v-prokofev/wtrans/docs/connection_guide.md

# Инструкция по подключению конвертера (для инженеров)

## 1. Что тебе понадобится
1. **Блок питания**: 24В постоянного тока (DC).
2. **Преобразователь USB-RS485**: 2 штуки (один для датчика, если хочешь проверить его отдельно, второй — для отладки нашей платы).
3. **Датчик ДВУ-01**.
4. **Прямые руки и отвертка**.

---

## 2. Шаг 1: Подключение датчика ДВУ-01 к нашей плате
Датчик подключается к разъемам **X2** (данные) и **X7/X12** (питание).

| Контакт датчика | Сигнал | Куда втыкать на нашей плате |
| :--- | :--- | :--- |
| **1** | DATA- (B) | **X2 - контакт 2** (B) |
| **2** | DATA+ (A) | **X2 - контакт 1** (A) |
| **3** | +12...24V | **X7 (или X12) - контакт 1** (+) |
| **4** | GND | **X7 (или X12) - контакт 2** (-) |

> **Важно:** Если перепутаешь A и B, ничего не сгорит, но данные не пойдут. Если перепутаешь + и - на питании — датчику может стать плохо. Будь внимателен!

---

## 3. Шаг 2: Подключение к компьютеру (Отладка)
Чтобы видеть, что происходит внутри платы, подключаем компьютер к разъему **X3**. Тебе понадобится свисток USB-RS485.

1. **Соедини провода**:
    *   Свисток **A** -> **X3 - контакт 1** (A)
    *   Свисток **B** -> **X3 - контакт 2** (B)
2. **Настрой компьютер**:
    *   Открой **PuTTY** или любую терминалку.
    *   Выбери нужный COM-порт.
    *   Скорость: **115200**.
    *   Data bits: **8**, Stop bits: **1**, Parity: **None**.

---

## 4. Шаг 3: Питание системы
Подай 24В на разъем **X6**.

*   **X6 - контакт 1**: +24В
*   **X6 - контакт 2**: Общий (GND)

---

## 5. Как понять, что всё работает (Светодиод PA9)
После подачи питания посмотри на светодиод на плате:

1. **Мигает РЕДКО (раз в 2 секунды)**:
    *   Плата работает, но **НЕ ВИДИТ** датчик.
    *   Проверь провода на X2.
    *   Проверь, подано ли питание на датчик (X7).
    *   Поменяй местами A и B на разъеме X2.
2. **Мигает ЧАСТО (5 раз в секунду)**:
    *   Всё супер! Плата получает данные от датчика и гонит ток в петлю.
3. **Вообще не горит**:
    *   Либо нет питания на X6, либо ты очень везучий и сжег плату.

---

## 6. Подключение токовой петли и проверка мультиметром (4-20 мА)
Чтобы проверить, что плата реально выдает нужный ток, тебе понадобится мультиметр.

### Как мерить ток (Инструкция для тех, кто забыл):
1. **Переткни щупы**: Красный щуп мультиметра должен стоять в гнезде **"mA"**, а не в "V".
2. **Режим**: Поставь переключатель в положение **mA DC** (постоянный ток).
3. **Подключение**: Мультиметр подключается **В РАЗРЫВ** цепи (последовательно).

### Схема подключения к нашей плате:
*   **Вариант А (простая проверка)**: 
    *   Просто ткни щупами в разъем петли: Красный к **LOOP_P (+)**, Черный к **LOOP_N (-)**. 
    *   Мультиметр сам станет "нагрузкой" и покажет ток.
*   **Вариант Б (в работающей системе)**:
    *   `Плата (LOOP_P)` -> `Прибор (+)`
    *   `Прибор (-)` -> `Щуп мультиметра (+)`
    *   `Щуп мультиметра (-)` -> `Плата (LOOP_N)`

### Что ты должен увидеть:
*   Если датчик не подключен: **3.5 мА** (наш Low Error).
*   Если всё Ок и штиль: **4.0 мА**.
*   Если дует на всю катушку (60 м/с): **20.0 мА**.

> **ОПАСНО:** Самая частая ошибка — оставить щупы в гнезде **mA** (низкое сопротивление) и полезть ими мерить напряжение на входе **X6 (24V)**. 
> В этом случае мультиметр сработает как кусок толстой проволоки и устроит **короткое замыкание**. 
> **Правило:** Сначала меряешь напряжение на питании (режим V), и ТОЛЬКО ПОТОМ перетыкаешь щуп в mA, чтобы лезть в токовую петлю.
