v-prokofev/wtrans/(list of files, drawings)

Other design files:
pcb/An_IF_Converter_V1.0.PrjPcb
pcb/LOOP_DAC.SchDoc
pcb/MCU.SchDoc
pcb/MECHANICAL.SchDoc
pcb/POWER.SchDoc
pcb/SERIAL_IF.SchDoc
pcb/TOP.SchDoc
