v-prokofev/wtrans/fw/Core/Src/dac.c

/**
 * @file    dac.c
 * @brief   DAC161S997 driver — two independent 4-20 mA current loop outputs.
 *
 * Hardware connections (from project_spec.md):
 *   SPI1  : PA5=SCK, PA6=MISO, PA7=MOSI  (Full-Duplex Master, 1.125 MHz)
 *   DAC1  : PA4 = nCS  (Speed channel)
 *   DAC2  : PB0 = nCS  (Direction channel)
 *   nERR1 : PB1 = DAC1 error flag (active LOW)
 *   nERR2 : PB2 = DAC2 error flag (active LOW)
 *
 * DAC161S997 protocol:
 *   - 3-byte SPI frames: [Addr(8)] [Data_MSB(8)] [Data_LSB(8)]
 *   - CPOL=0, CPHA=1 (Mode 1)  — see datasheet p.23
 *   - CS active LOW, toggled around each 3-byte transaction
 *
 * Current formula:
 *   I_out = (CODE / 65536) * 24 mA
 *   CODE  = (I_mA / 24.0) * 65536
 */

#include "dac.h"
#include <stddef.h>

/* -------------------------------------------------------------------------
 * Private variables
 * ------------------------------------------------------------------------- */
static SPI_HandleTypeDef *_hspi = NULL;

/* Last written codes — used for SPI keepalive refresh */
static uint16_t _last_code[3] = {0};  /* index 1=SPEED, 2=DIRECTION */

/* -------------------------------------------------------------------------
 * Private helpers
 * ------------------------------------------------------------------------- */

/** Assert chip-select for the given channel (drive CS LOW). */
static inline void cs_select(uint8_t channel)
{
    if (channel == DAC_CHANNEL_SPEED)
        HAL_GPIO_WritePin(GPIOB, GPIO_PIN_0, GPIO_PIN_RESET); /* PB0 = pin 18 = DAC1_nCS */
    else
        HAL_GPIO_WritePin(GPIOA, GPIO_PIN_4, GPIO_PIN_RESET); /* PA4 = pin 14 = DAC2_nCS */
}

/** Deassert chip-select for the given channel (drive CS HIGH). */
static inline void cs_deselect(uint8_t channel)
{
    if (channel == DAC_CHANNEL_SPEED)
        HAL_GPIO_WritePin(GPIOB, GPIO_PIN_0, GPIO_PIN_SET);   /* PB0 = pin 18 = DAC1_nCS */
    else
        HAL_GPIO_WritePin(GPIOA, GPIO_PIN_4, GPIO_PIN_SET);   /* PA4 = pin 14 = DAC2_nCS */
}

/**
 * @brief  Write a 3-byte SPI frame to the DAC161S997 and capture MISO.
 *         Frame layout: [7:0]=addr, [15:8]=data_high, [23:16]=data_low
 *         On return, rx[1..2] contain the previous register value echoed by the DAC.
 */
static void DAC_TransceiveReg(uint8_t channel, uint8_t addr, uint16_t data, uint8_t *rx_out)
{
    uint8_t tx[3];
    uint8_t rx[3] = {0};
    tx[0] = addr;
    tx[1] = (uint8_t)(data >> 8);
    tx[2] = (uint8_t)(data & 0xFF);

    cs_select(channel);
    HAL_SPI_TransmitReceive(_hspi, tx, rx, 3, 10);
    cs_deselect(channel);

    if (rx_out) {
        rx_out[0] = rx[0];
        rx_out[1] = rx[1];
        rx_out[2] = rx[2];
    }
}

/** Write without caring about MISO. */
static void DAC_WriteReg(uint8_t channel, uint8_t addr, uint16_t data)
{
    DAC_TransceiveReg(channel, addr, data, NULL);
}

/* 
 * Optional software calibration to compensate for systematic board offsets.
 * Under these settings:
 *   - Target 4.0 mA  -> calibrated to DAC code for 1.30 mA -> physical loop current matches ~4.0 mA.
 *   - Target 20.0 mA -> calibrated to DAC code for 17.92 mA -> physical loop current matches ~20.0 mA.
 */
#define CALIBRATION_ENABLED 0   /* Set to 1 to enable software calibration */
#define CAL_SLOPE           0.9625f
#define CAL_OFFSET          2.75f

/** Convert mA to a 16-bit DAC code. Input is clamped to [0, 24] mA. */
static uint16_t mA_to_code(float mA)
{
#if CALIBRATION_ENABLED
    /* y = (x - offset) / slope */
    float calibrated_mA = (mA - CAL_OFFSET) / CAL_SLOPE;
    if (calibrated_mA < 0.0f) calibrated_mA = 0.0f;
    mA = calibrated_mA;
#endif

    if (mA < 0.0f)  mA = 0.0f;
    if (mA > DAC_CURRENT_FULLSCALE_MA) mA = DAC_CURRENT_FULLSCALE_MA;
    uint32_t code = (uint32_t)((mA / DAC_CURRENT_FULLSCALE_MA) * 65536.0f);
    if (code > 0xFFFF) code = 0xFFFF;
    return (uint16_t)code;
}

/** Configure one DAC channel: enable normal mode, no loopback. */
static void DAC_ConfigChannel(uint8_t channel)
{
    /* RESET register — soft reset */
    DAC_WriteReg(channel, DAC161S997_REG_RESET, 0xC33C);
    HAL_Delay(1);

    /* WR_MODE: normal write mode (0x0000 = direct write, no loopback) */
    DAC_WriteReg(channel, DAC161S997_REG_WR_MODE, 0x0000);

    /*
     * ERR_CONFIG: mask ALL error sources for now so nERR stays quiet.
     * DAC161S997 ERR_CONFIG bits (from datasheet table 15):
     *   bit 0  MASK_LOOP_ERR  — mask loop current error → nERR
     *   bit 1  MASK_SPI_TOUT  — mask SPI timeout        → nERR
     *   bit 2  MASK_SPI_ERR   — mask SPI frame error    → nERR
     * Setting all bits = 0x0007 suppresses all nERR toggling.
     * Un-mask selectively once SPI readback is confirmed working.
     */
    DAC_WriteReg(channel, DAC161S997_REG_ERR_CONFIG, 0x0007);

    /* Preset to error level until real data arrives */
    DAC_WriteReg(channel, DAC161S997_REG_DACCODE, mA_to_code(DAC_CURRENT_ERROR_MA));
}

/* -------------------------------------------------------------------------
 * Public API
 * ------------------------------------------------------------------------- */

void DAC_Init(SPI_HandleTypeDef *hspi)
{
    _hspi = hspi;

    /* Both CS lines idle HIGH */
    cs_deselect(DAC_CHANNEL_SPEED);
    cs_deselect(DAC_CHANNEL_DIRECTION);

    HAL_Delay(2); /* Power-on stabilisation */

    DAC_ConfigChannel(DAC_CHANNEL_SPEED);
    DAC_ConfigChannel(DAC_CHANNEL_DIRECTION);

    /* Seed keepalive cache so DAC_Refresh() fires immediately from t=0,
     * preventing SPI timeout before the first sensor reading arrives. */
    _last_code[DAC_CHANNEL_SPEED]     = mA_to_code(DAC_CURRENT_ERROR_MA);
    _last_code[DAC_CHANNEL_DIRECTION] = mA_to_code(DAC_CURRENT_ERROR_MA);
}

void DAC_WriteCode(uint8_t channel, uint16_t code)
{
    if (_hspi == NULL) return;
    _last_code[channel] = code;           /* Cache for refresh */
    DAC_WriteReg(channel, DAC161S997_REG_DACCODE, code);
}

void DAC_SetCurrent(uint8_t channel, float mA)
{
    /* Clamp to valid output range */
    if (mA < DAC_CURRENT_ERROR_MA) mA = DAC_CURRENT_ERROR_MA;
    if (mA > DAC_CURRENT_MAX_MA)   mA = DAC_CURRENT_MAX_MA;
    DAC_WriteCode(channel, mA_to_code(mA));
}

void DAC_UpdateOutputs(float speed_ms, float dir_deg)
{
    /* Speed: 0..60 m/s -> 4..20 mA */
    float spd_mA = DAC_CURRENT_MIN_MA + (speed_ms / 60.0f) * 16.0f;

    /* Direction: 0..360 deg -> 4..20 mA */
    float dir_mA = DAC_CURRENT_MIN_MA + (dir_deg / 360.0f) * 16.0f;

    DAC_SetCurrent(DAC_CHANNEL_SPEED,     spd_mA);
    DAC_SetCurrent(DAC_CHANNEL_DIRECTION, dir_mA);
}

void DAC_SetError(void)
{
    DAC_SetCurrent(DAC_CHANNEL_SPEED,     DAC_CURRENT_ERROR_MA);
    DAC_SetCurrent(DAC_CHANNEL_DIRECTION, DAC_CURRENT_ERROR_MA);
}

uint8_t DAC_ReadErrors(void)
{
    uint8_t err = 0;
    /* nERR pins are active LOW — low = fault */
    if (HAL_GPIO_ReadPin(GPIOB, GPIO_PIN_2) == GPIO_PIN_RESET) err |= 0x01; /* DAC1: PB2 = pin 20 = DAC1_nERR */
    if (HAL_GPIO_ReadPin(GPIOB, GPIO_PIN_1) == GPIO_PIN_RESET) err |= 0x02; /* DAC2: PB1 = pin 19 = DAC2_nERR */
    return err;
}

uint16_t DAC_ReadStatus(uint8_t channel)
{
    uint8_t rx[3] = {0};

    /*
     * DAC161S997 echo protocol:
     *   Frame N:   send [ADDR][DATA]  → MISO echoes frame N-1's register
     *   Frame N+1: send [NOOP][0000]  → MISO echoes frame N's register
     *
     * So to read STATUS:
     *   1. Write to STATUS address — triggers chip to latch STATUS for next echo
     *   2. Send NOOP — MISO outputs STATUS contents
     *   Both frames have CS toggled between them (required by DAC161S997).
     */
    DAC_TransceiveReg(channel, DAC161S997_REG_STATUS, 0x0000, NULL); /* prime echo */
    DAC_TransceiveReg(channel, 0x00, 0x0000, rx);                    /* read echo  */

    return (uint16_t)((rx[1] << 8) | rx[2]);
}

/**
 * @brief  SPI connectivity probe: write a known code to DACCODE, then echo-read it.
 *         If MISO is floating HIGH → returns 0xFFFF.
 *         If MISO is floating LOW  → returns 0x0000.
 *         If SPI is working        → returns the code we just wrote.
 * @param  channel  DAC_CHANNEL_SPEED or DAC_CHANNEL_DIRECTION
 * @param  probe_code  value to write (suggest 0xA5A5 for easy bit-pattern check)
 * @retval echo of the probe write (should equal probe_code if SPI OK)
 */
uint16_t DAC_SpiProbe(uint8_t channel, uint16_t probe_code)
{
    uint8_t rx[3] = {0};
    /* Write probe_code to DACCODE — this will be echoed next transaction */
    DAC_TransceiveReg(channel, DAC161S997_REG_DACCODE, probe_code, NULL);
    /* NOOP — MISO echoes the DACCODE write above */
    DAC_TransceiveReg(channel, 0x00, 0x0000, rx);
    return (uint16_t)((rx[1] << 8) | rx[2]);
}

void DAC_Refresh(void)
{
    /* Re-send the last written DAC codes to keep SPI watchdog alive */
    if (_last_code[DAC_CHANNEL_SPEED] > 0)
        DAC_WriteReg(DAC_CHANNEL_SPEED,     DAC161S997_REG_DACCODE, _last_code[DAC_CHANNEL_SPEED]);
    if (_last_code[DAC_CHANNEL_DIRECTION] > 0)
        DAC_WriteReg(DAC_CHANNEL_DIRECTION, DAC161S997_REG_DACCODE, _last_code[DAC_CHANNEL_DIRECTION]);
}
