v-prokofev/wtrans/(commit log)

2026-04-28 Fix DAC hang, configure 16MHz HSE clock, remove LED toggle
    [main.c]
2026-04-28 Remove pcb files
    [AN_IF_Converter_V1.0.GBL, AN_IF_Converter_V1.0.GBO, AN_IF_Converter_V1.0.GBP, AN_IF_Converter_V1.0.GBS, AN_IF_Converter_V1.0.GTL, AN_IF_Converter_V1.0.GTO, AN_IF_Converter_V1.0.GTP, AN_IF_Converter_V1.0.GTS]
2026-04-30 Integrated DAC161S997 driver, restored stable RS-485 sensor polling and implemented 4-20mA current loop output for wind speed and direction
2026-04-30 Reverted to stable yesterday's state (ea75f0c) with functional RS-485 polling and raw debug output, removing experimental DAC implementation
    [main.c]
2026-04-30 Reverted to 9c3bf09 (yesterday's stable state before DAC implementation)
    [main.c]
2026-05-25 сщтыщду
